juhakaup/keyboards/Cygnus v1.0/img/3x6.jpg

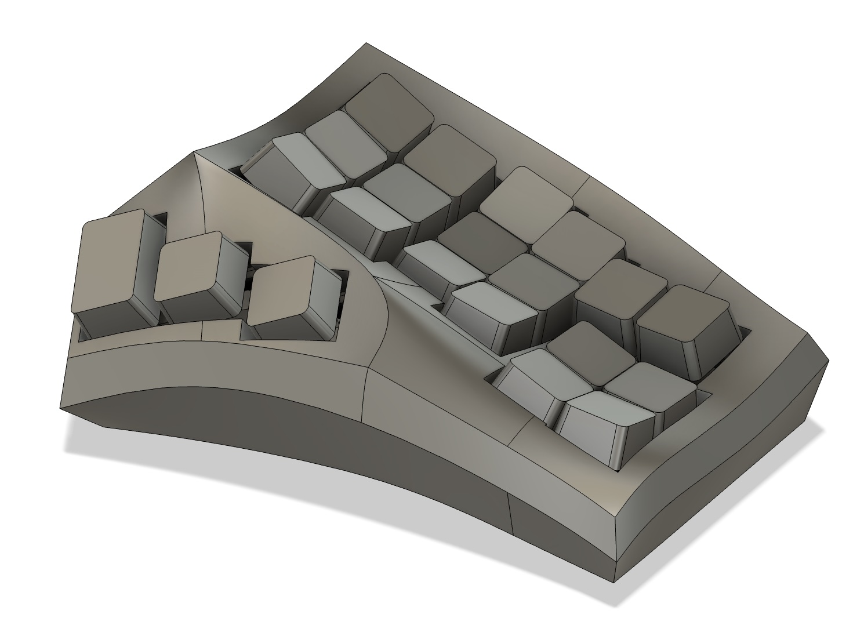
Cygnus v1.0/img/3x6.jpg
