juhakaup/keyboards/Cygnus v1.0/img/3x6_refined.jpg

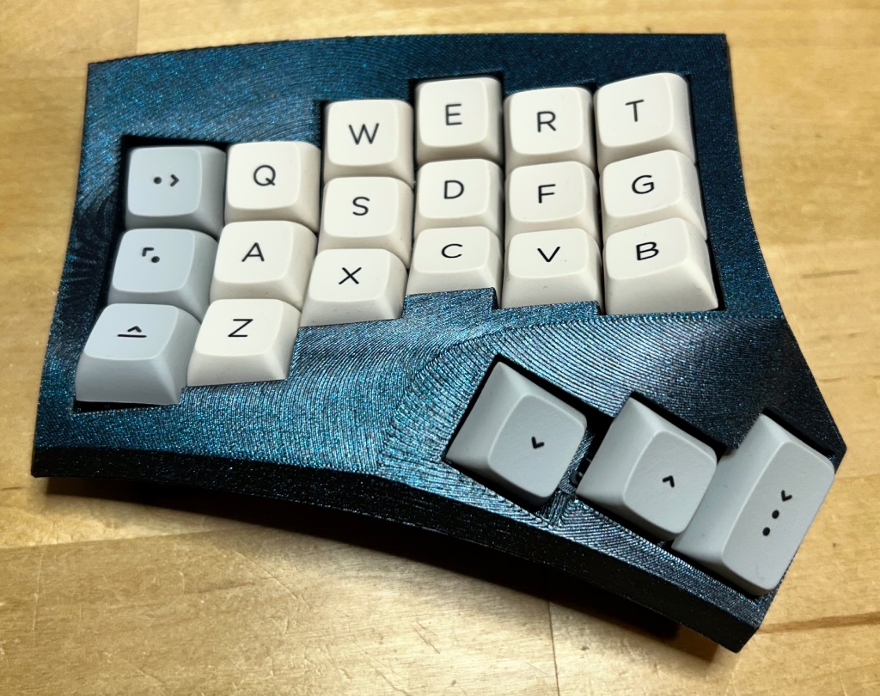
Cygnus v1.0/img/3x6_refined.jpg
