juhakaup/keyboards/Cygnus v1.0/img/4x6and3x5.jpg

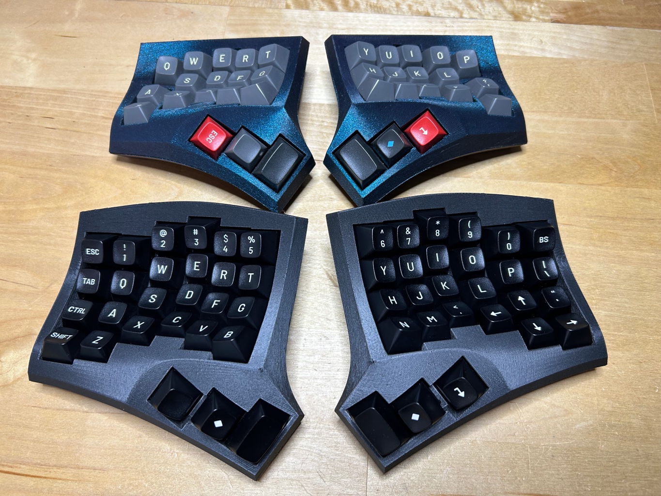
Cygnus v1.0/img/4x6and3x5.jpg
