juhakaup/keyboards/Cygnus v1.0/img/cygnus2.jpg

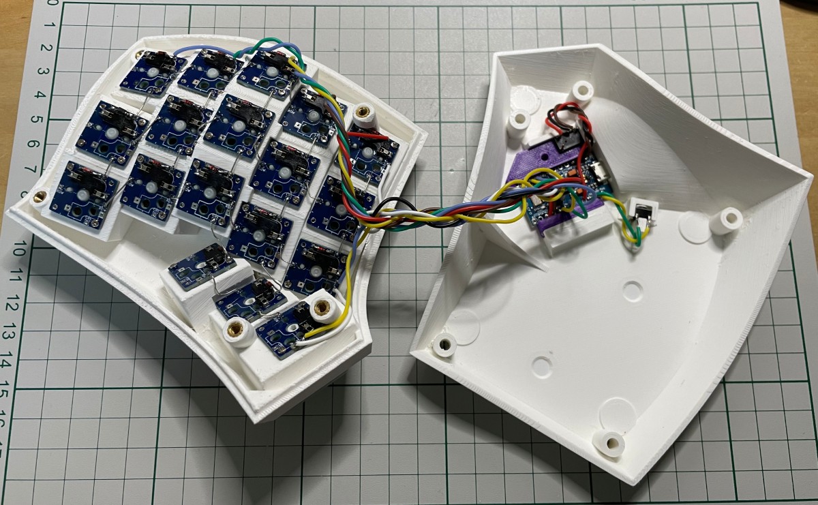
Cygnus v1.0/img/cygnus2.jpg
