juhakaup/keyboards/Cygnus v1.0/img/cygnus3.jpg

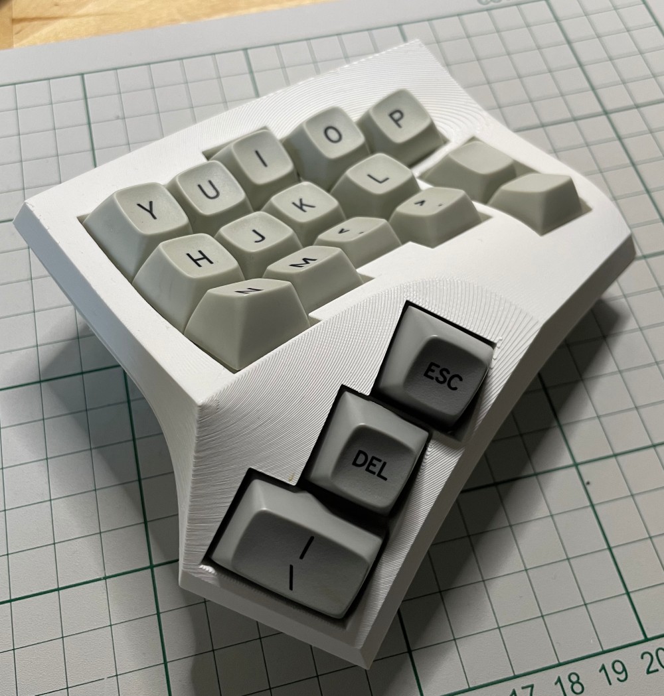
Cygnus v1.0/img/cygnus3.jpg
