juhakaup/keyboards/Cygnus v1.0/img/cygnus4.jpg

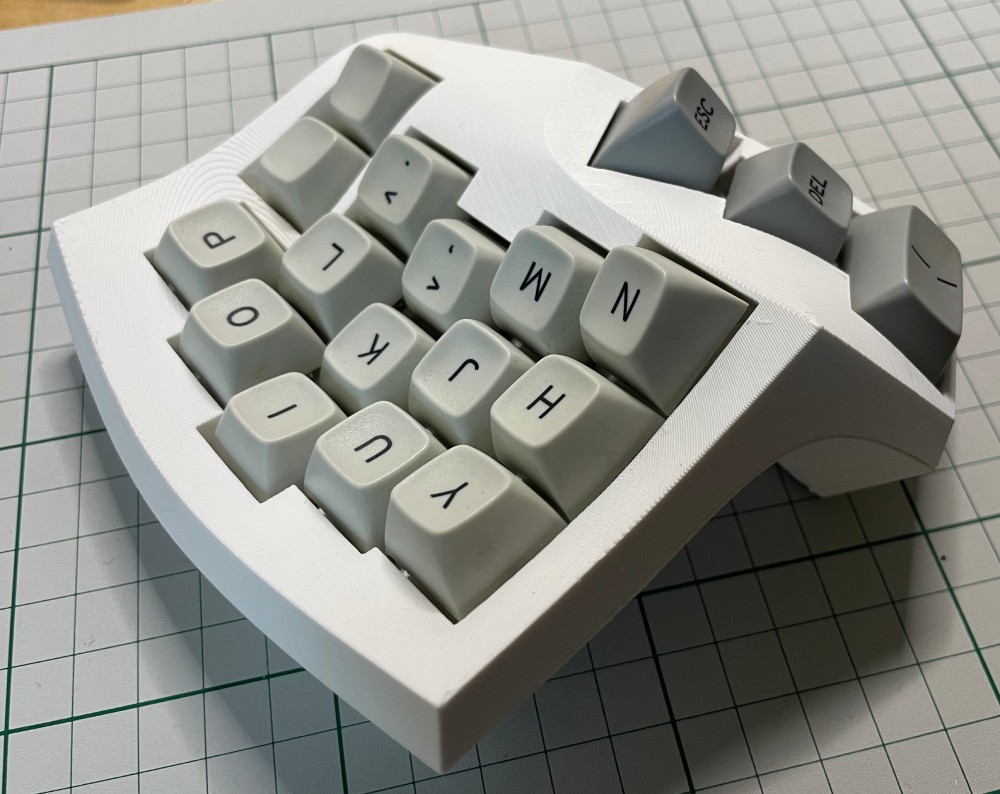
Cygnus v1.0/img/cygnus4.jpg
