juhakaup/keyboards/Cygnus v1.0/img/cygnus_wireless.jpg

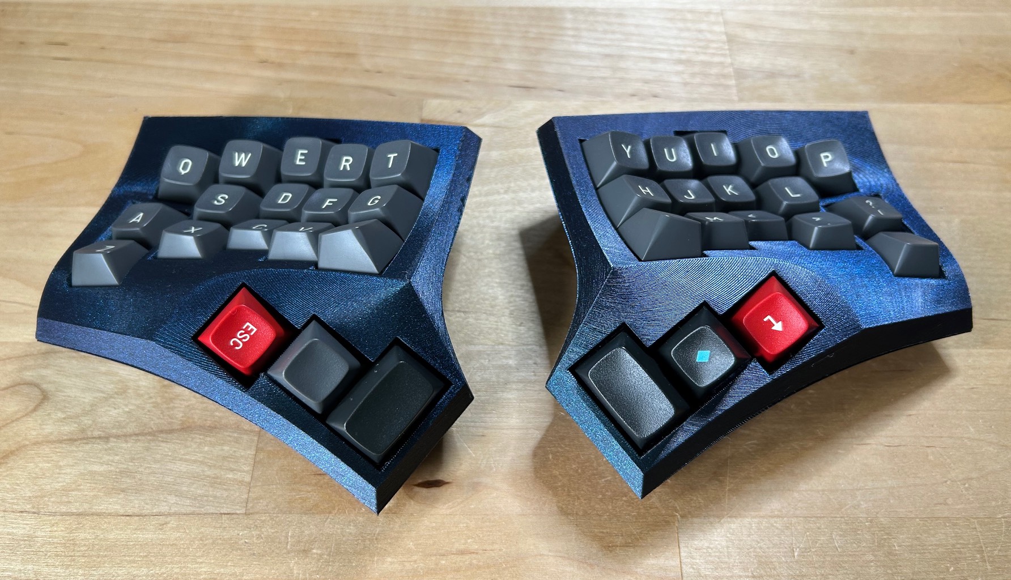
Cygnus v1.0/img/cygnus_wireless.jpg
