juhakaup/keyboards/Cygnus v1.0/img/fusion1.png

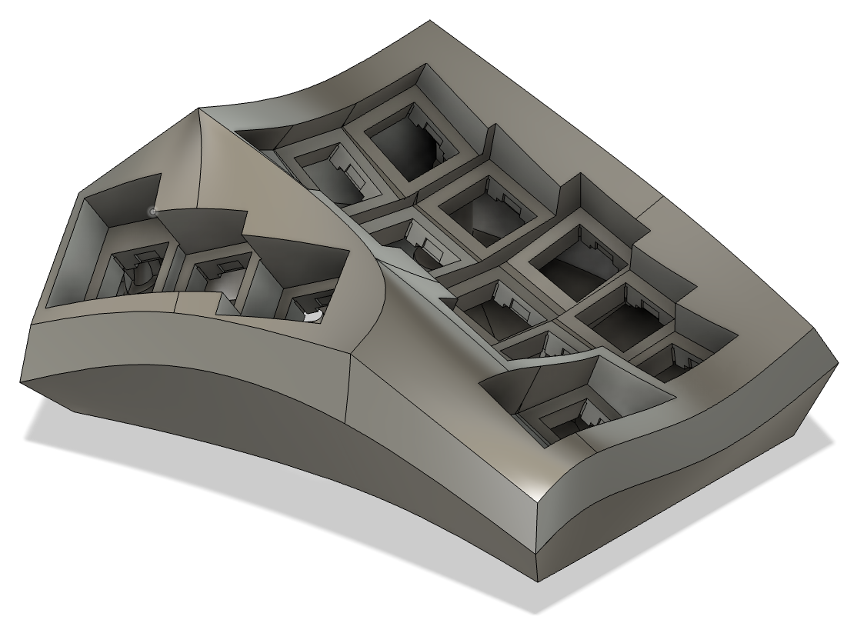
Cygnus v1.0/img/fusion1.png
