juhakaup/keyboards/Cygnus v1.0/img/fusion2.png

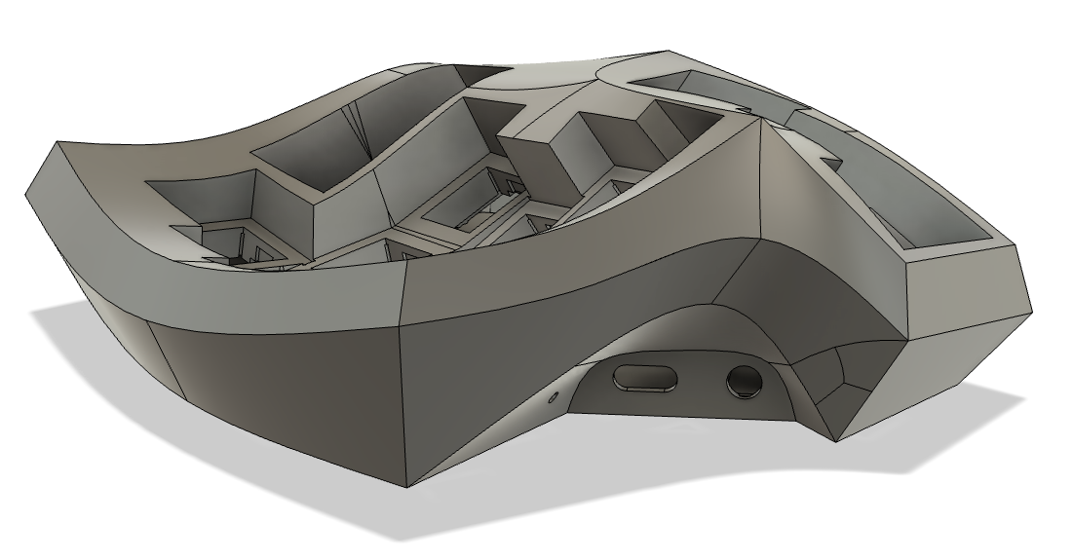
Cygnus v1.0/img/fusion2.png
