juhakaup/keyboards/Cygnus v1.0/img/fusion3.png

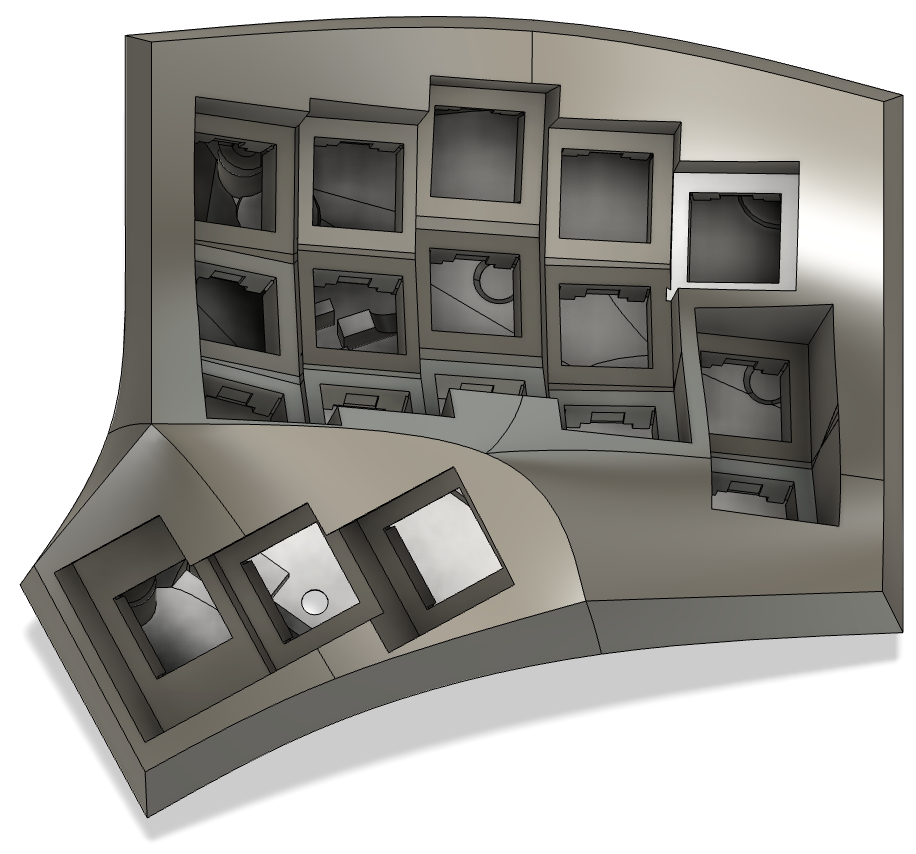
Cygnus v1.0/img/fusion3.png
