juhakaup/keyboards/Cygnus v1.0/img/fusion_unified_col5.png

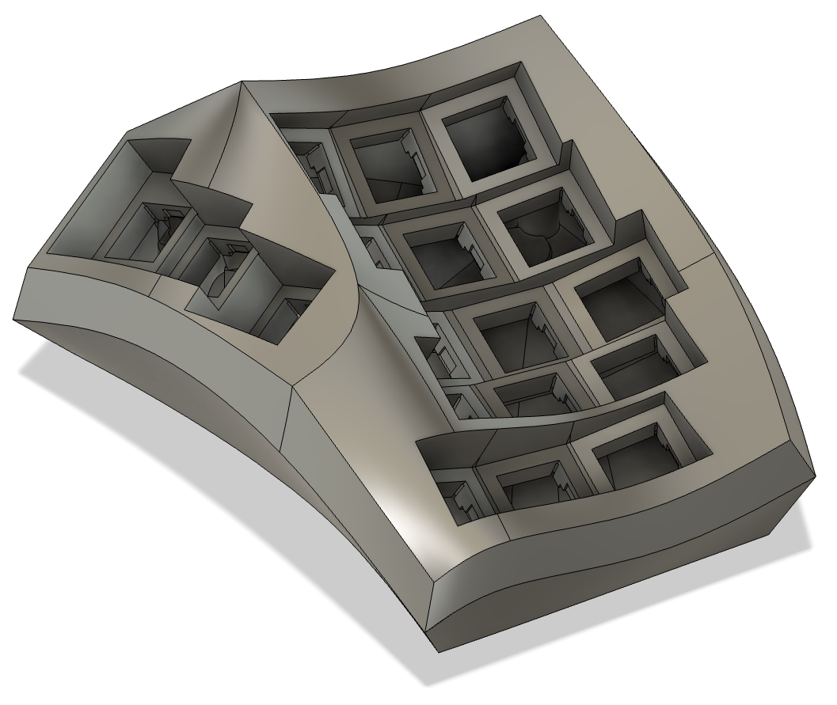
Cygnus v1.0/img/fusion_unified_col5.png
