juhakaup/keyboards/Cygnus v1.0/img/unicol_draft.jpg

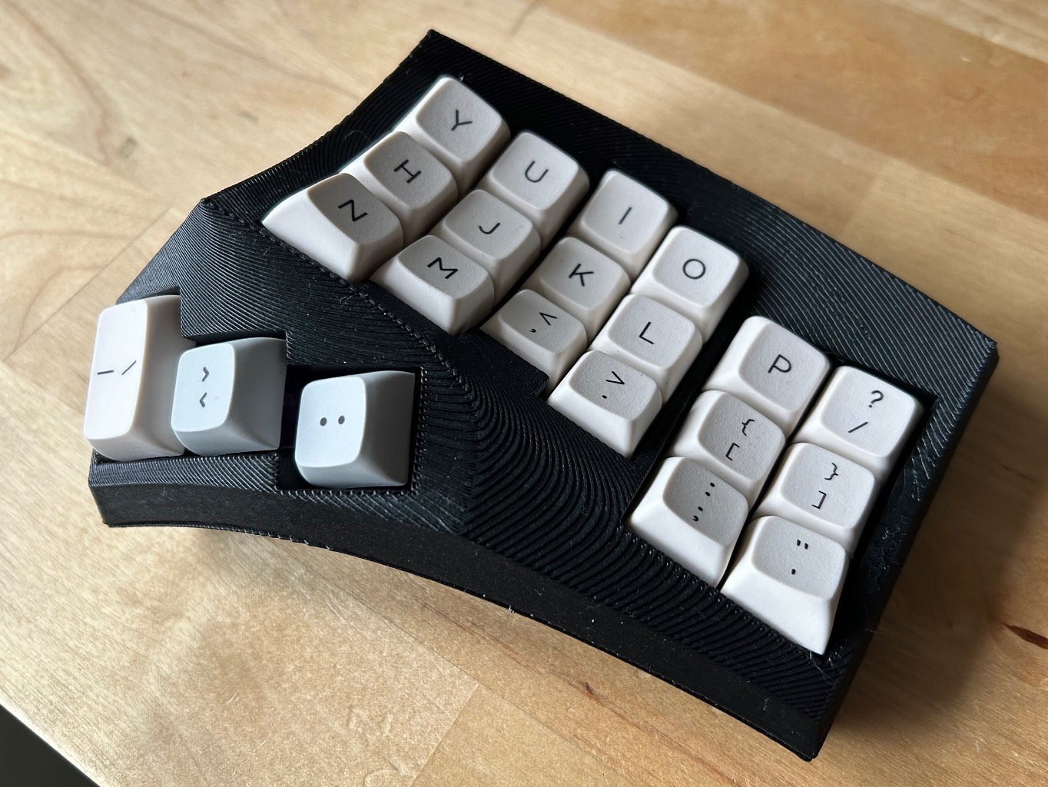
Cygnus v1.0/img/unicol_draft.jpg
