juhakaup/keyboards/Cygnus v1.0/requests and other experiments/controller_holder_rp2040/controller_holder_rp2040z_adapter.stl

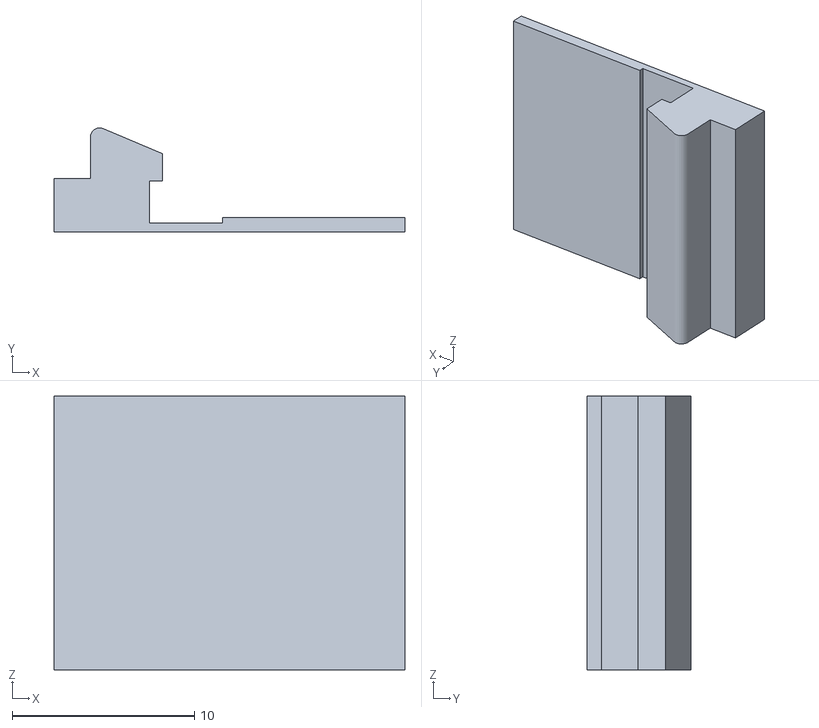
[picture p64: CAD file, 2024-09-02]
Cygnus v1.0/requests and other experiments/controller_holder_rp2040/controller_holder_rp2040z_adapter.stl
19.3 x 5.71 x 15.0
