juhakaup/keyboards/Cygnus v1.0/requests and other experiments/cygnus_top_unicol_2thumbkeys.step

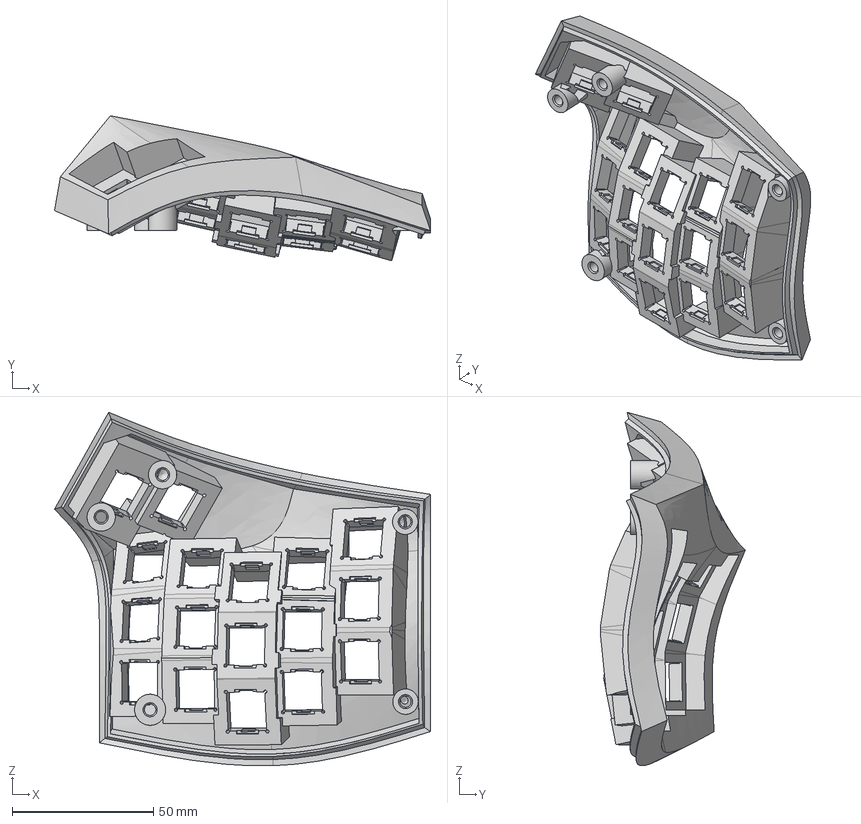
[picture p65: CAD file, 2024-04-13]
Cygnus v1.0/requests and other experiments/cygnus_top_unicol_2thumbkeys.step
132.9 x 51.1 x 125.0 mm
