juhakaup/keyboards/Cygnus v1.0/stl/controller_holders/controller holder xiao.step

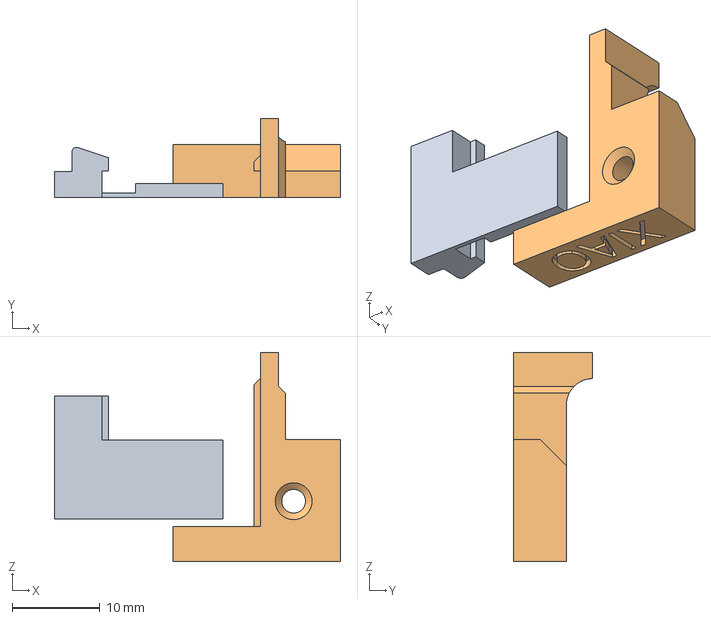
[picture p66: CAD file, 2024-10-27]
Cygnus v1.0/stl/controller_holders/controller holder xiao.step
32.7 x 9.00 x 23.9 mm
