juhakaup/keyboards/Cygnus v1.0/stl/cygnus 3x5/cygnus_3x5_top.step

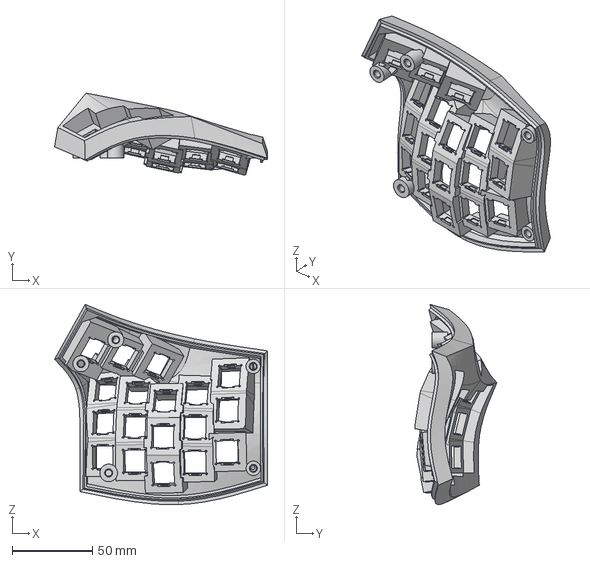
[picture p67: CAD file, 2024-04-06]
Cygnus v1.0/stl/cygnus 3x5/cygnus_3x5_top.step
132.9 x 51.1 x 125.0 mm
