juhakaup/keyboards/Cygnus v1.0/stl/cygnus 3x6/cygnus_3x6_bottom_wireless.step

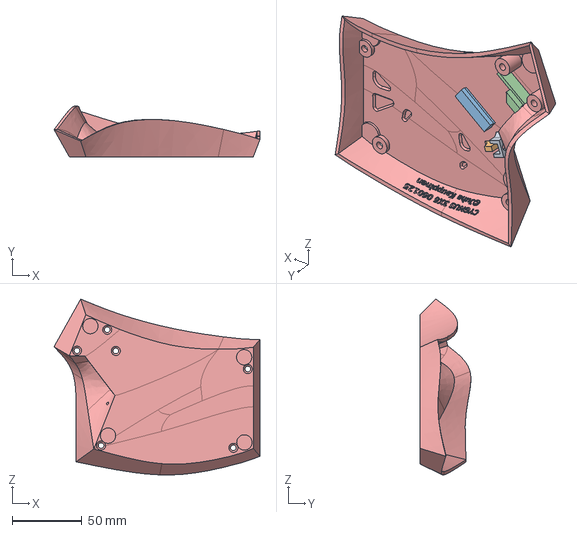
[picture p68: CAD file, 2025-01-10]
Cygnus v1.0/stl/cygnus 3x6/cygnus_3x6_bottom_wireless.step
147.9 x 36.4 x 126.3 mm
reset switch holder
controller holder wireless
