juhakaup/keyboards/Cygnus v1.0/stl/cygnus 4x6/cygnus_4x6_bottom_wireless.step

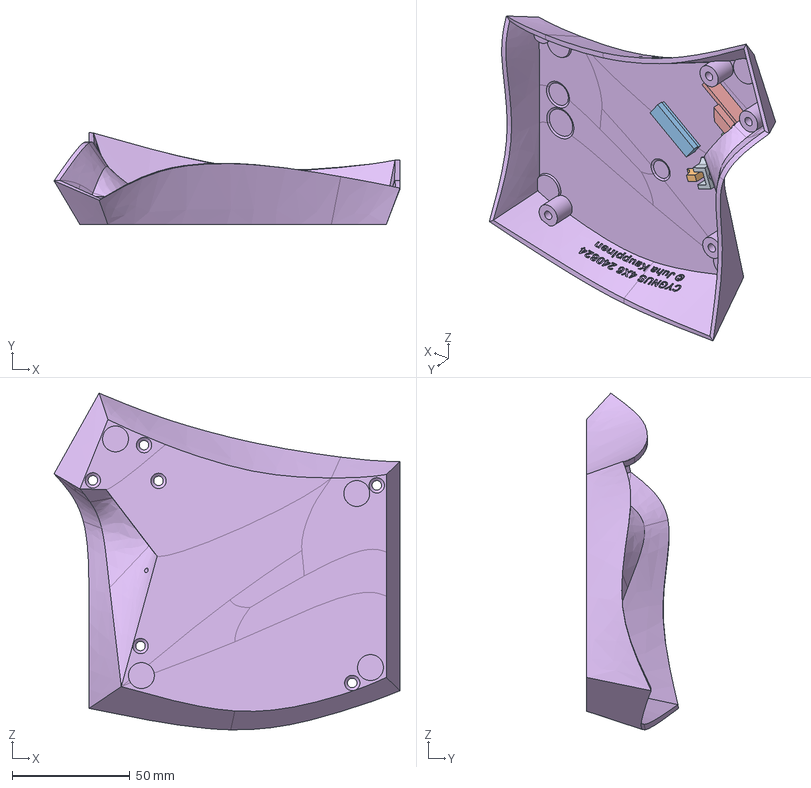
[picture p69: CAD file, 2024-09-14]
Cygnus v1.0/stl/cygnus 4x6/cygnus_4x6_bottom_wireless.step
146.9 x 39.1 x 143.0 mm
Thumb cluster
reset switch holder
controller holder wireless
