juhakaup/keyboards/Cygnus v1.0/requests and other experiments/controller_holder_rp2040/controller_holder_rp2040z_clamp.stl

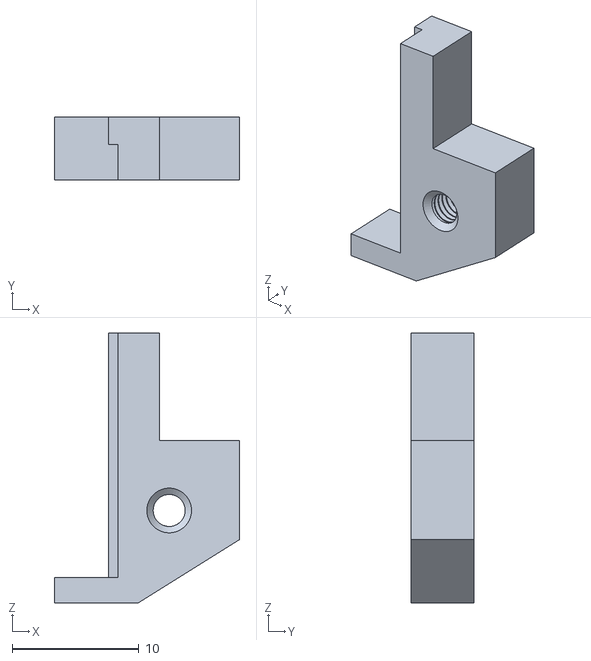
[picture p70: CAD file, 2024-09-02]
Cygnus v1.0/requests and other experiments/controller_holder_rp2040/controller_holder_rp2040z_clamp.stl
14.6 x 5.00 x 21.3
