juhakaup/keyboards/Cygnus v1.0/stl/controller_holders/controller_holder_supermini_wireless.stl

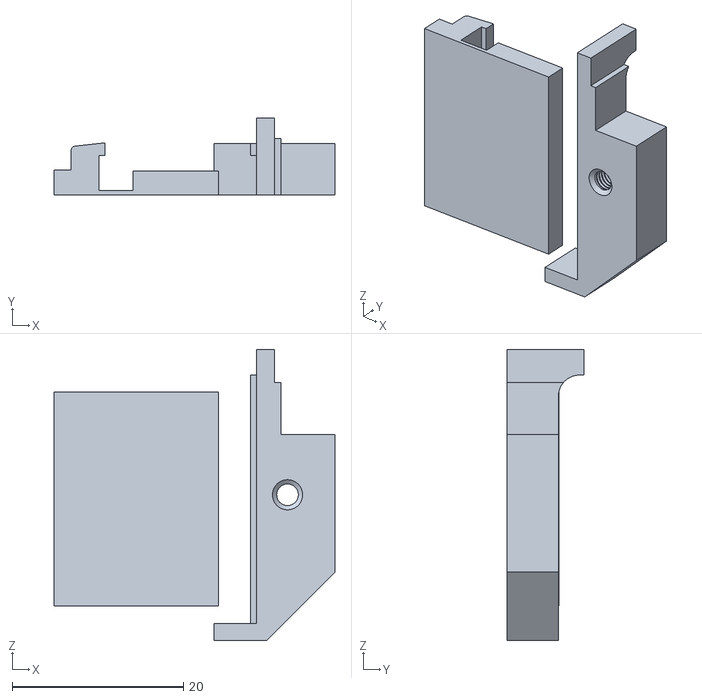
[picture p71: CAD file, 2024-03-31]
Cygnus v1.0/stl/controller_holders/controller_holder_supermini_wireless.stl
32.8 x 9.00 x 34.0
