juhakaup/keyboards/Cygnus v1.0/stl/cygnus 3x6/cygnus_3x6_top.step

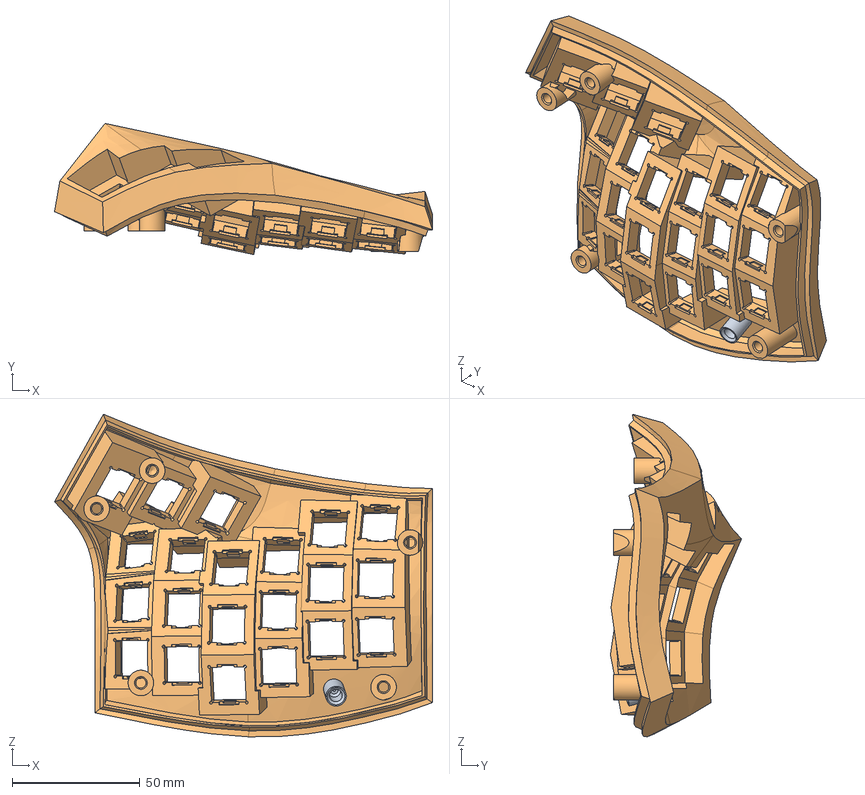
[picture p73: CAD file, 2025-01-10]
Cygnus v1.0/stl/cygnus 3x6/cygnus_3x6_top.step
147.9 x 51.3 x 126.3 mm
