juhakaup/keyboards/Cygnus v1.0/stl/cygnus 4x6/cygnus_4x6_top.step

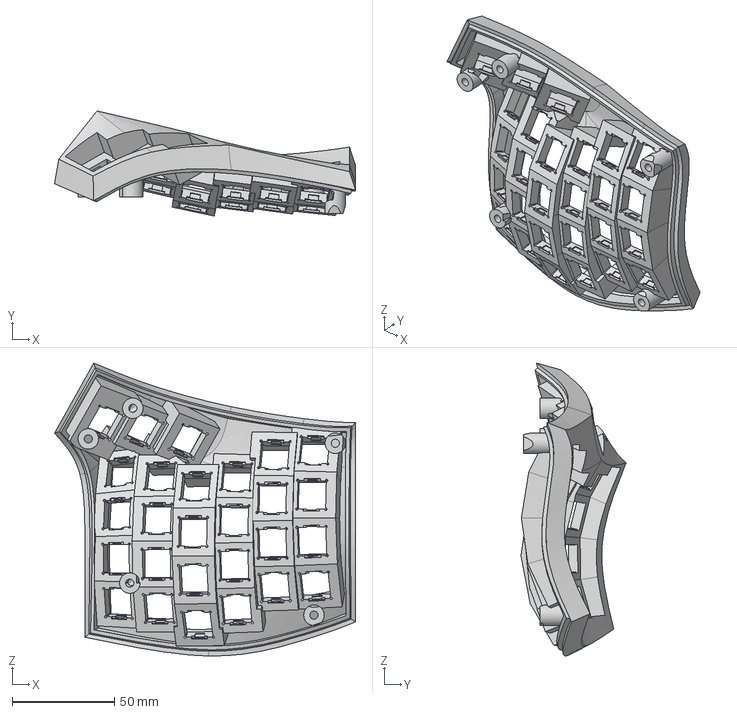
[picture p74: CAD file, 2024-09-14]
Cygnus v1.0/stl/cygnus 4x6/cygnus_4x6_top.step
146.9 x 51.3 x 143.0 mm
