juhakaup/keyboards/Cygnus v1.0/stl/controller_holders/controller_holder_rp2040zero.stl

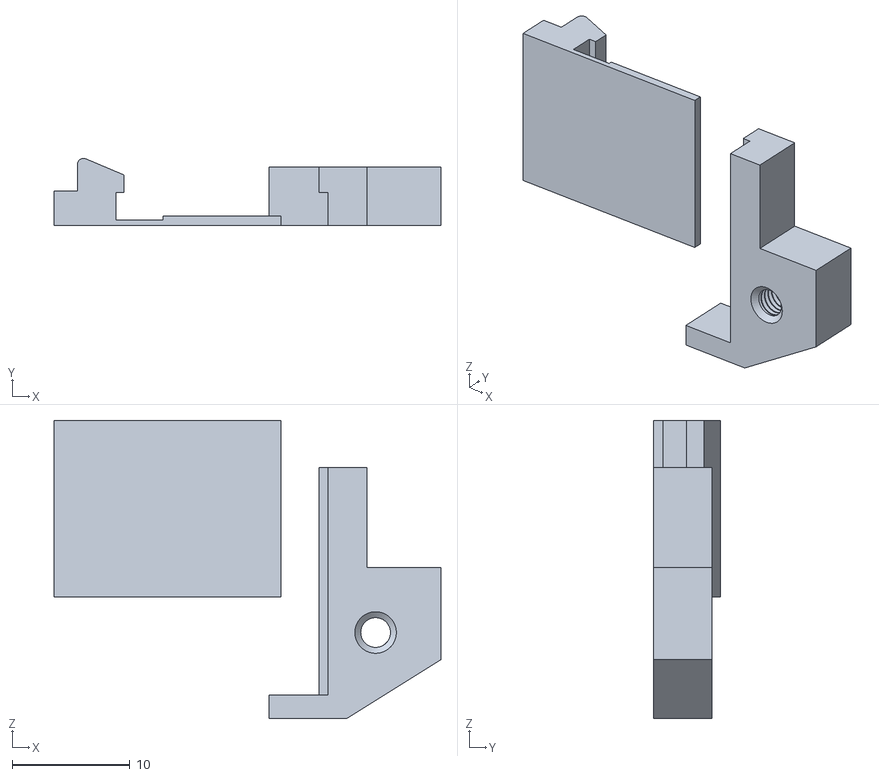
[picture p75: CAD file, 2023-10-15]
Cygnus v1.0/stl/controller_holders/controller_holder_rp2040zero.stl
32.8 x 5.71 x 25.3
