juhakaup/keyboards/Cygnus v1.0/stl/cygnus 3x5/cygnus_3x5_bottom.step

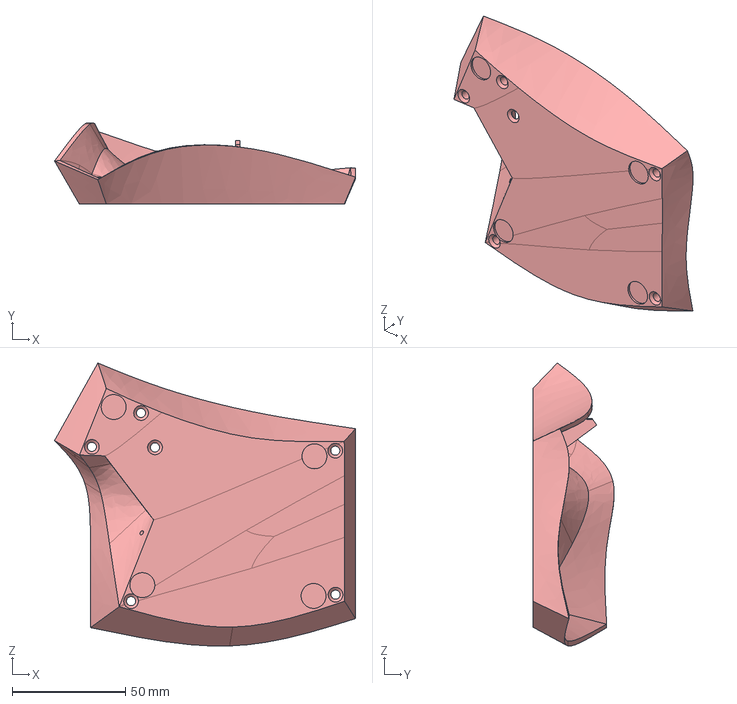
[picture p76: CAD file, 2024-04-06]
Cygnus v1.0/stl/cygnus 3x5/cygnus_3x5_bottom.step
132.9 x 35.9 x 125.0 mm
Switch
controller and jack
