juhakaup/keyboards/Cygnus v1.0/stl/controller_holders/controller_holder_elitec.stl

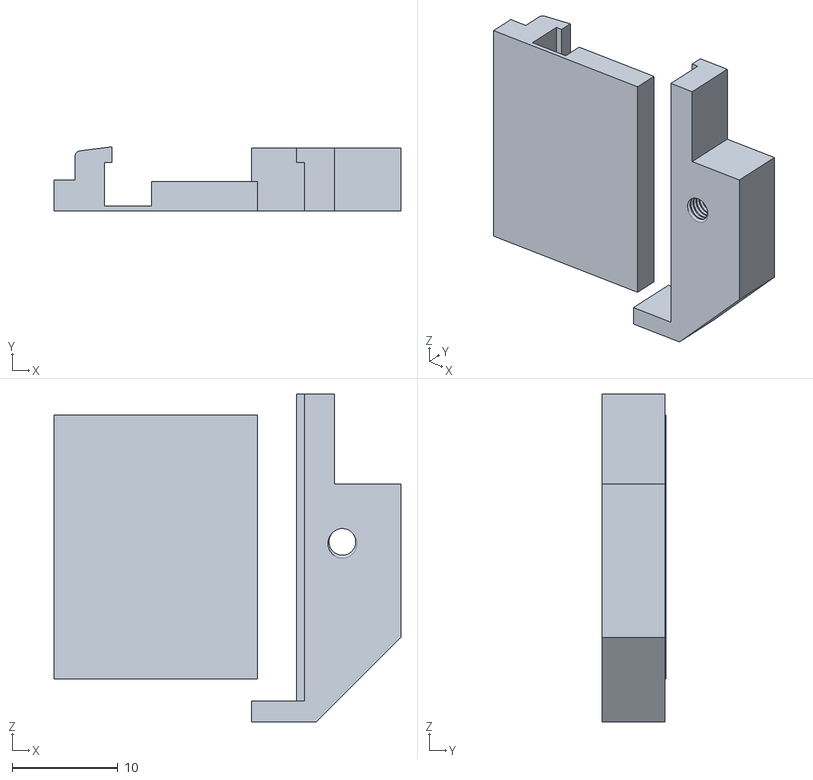
[picture p78: CAD file, 2023-10-15]
Cygnus v1.0/stl/controller_holders/controller_holder_elitec.stl
32.8 x 6.10 x 31.0
