juhakaup/keyboards/Cygnus v1.0/stl/controller_holders/controller_holder_promicro.stl

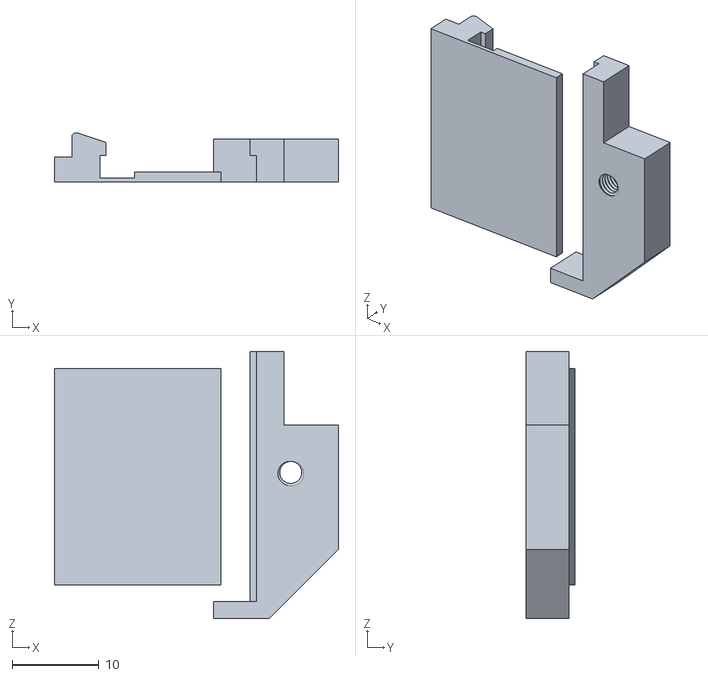
[picture p79: CAD file, 2023-10-15]
Cygnus v1.0/stl/controller_holders/controller_holder_promicro.stl
32.8 x 5.71 x 30.9
