juhakaup/keyboards/(list of files, cad)

Other CAD files:
Cygnus v1.0/requests and other experiments/cygnus_top_2thumbkeys.step
Cygnus v1.0/stl/cygnus 3x6/cygnus_3x6_bottom_wired.step
Cygnus v1.0/stl/cygnus 4x6/cygnus_4x6_bottom_wired.step
Cygnus v1.0/stl/cygnus 3x5/cygnus_3x5_top_unicol.step
Cygnus layout tester/sygnus_layout_tester.f3z
Cygnus v0.5/Case bottom.stl
Cygnus v0.5/Case top hotswap left.stl
Cygnus v0.5/Case top hotswap right.stl
Cygnus v0.5/Case top noswap.stl
Cygnus v0.5/Controller holder.stl
Cygnus v0.5/Jack holder.stl
Cygnus v1.0/requests and other experiments/cygnus_top_2thumbkeys.stl
Cygnus v1.0/requests and other experiments/cygnus_top_unicol_2thumbkeys.stl
Cygnus v1.0/requests and other experiments/old_3x6/cygnus_3x6_bottom.stl
Cygnus v1.0/requests and other experiments/old_3x6/cygnus_3x6_bottom_wireless.stl
Cygnus v1.0/requests and other experiments/old_3x6/cygnus_3x6_top.stl
Cygnus v1.0/requests and other experiments/old_3x6/cygnus_3x6_unicol_top.stl
Cygnus v1.0/stl/controller_holders/controller holder xiao.stl
Cygnus v1.0/stl/cygnus 3x5/cygnus_3x5_bottom.stl
Cygnus v1.0/stl/cygnus 3x5/cygnus_3x5_bottom_wireless.stl
Cygnus v1.0/stl/cygnus 3x5/cygnus_3x5_top.stl
Cygnus v1.0/stl/cygnus 3x5/cygnus_3x5_top_unicol.stl
Cygnus v1.0/stl/cygnus 3x6/cygnus_3x6_bottom_wired.stl
Cygnus v1.0/stl/cygnus 3x6/cygnus_3x6_bottom_wireless.stl
Cygnus v1.0/stl/cygnus 3x6/cygnus_3x6_top.stl
Cygnus v1.0/stl/cygnus 4x6/cygnus_4x6_bottom_wired.stl
Cygnus v1.0/stl/cygnus 4x6/cygnus_4x6_bottom_wireless.stl
Cygnus v1.0/stl/cygnus 4x6/cygnus_4x6_top.stl
