juhakaup/keyboards/(threads)

Thread 3 (2022-07-22):

Build guide please

tangbonze, 2022-07-22:
Hello there:
I am new to custom build Keeb. Your design really impressed me.
I can handle soldering but not sure the wire lines. Could you please kindly create a build guide or open the case and take a whole picture?
Thanks in advanced.

brneor, 2022-07-26:
+1 for some pics of the interior to help us see how you managed to fit the internals. It would be great!

evantravers, 2024-02-29:
I feel like the guide he has with the v1.0 is pretty doggone good: https://github.com/juhakaup/keyboards/tree/main/Cygnus%20v1.0

Maybe this is closed?

Closed 2024-03-03.

Thread 4 (2023-01-07):

Would it be possible to get the fusion files?

Nobodi99, 2023-01-07:
Hi,
I recently printed one half of your design to test and I really like the aesthetics but I would love to move the upper pinky key above the others and raise the innermost thumbkey because the middle key gets in the way for me.
Would it be possible to get access to the design files to modify it?

juhakaup, 2023-01-15:
Glad to hear you like the design.
Here is the link to the fusion files:
https://drive.google.com/file/d/1OVxvqivmw3vvyvD0ghFZgAA_TH4tXXlT/view?usp=sharing
Modifying the design may be quite challenging.

I'm working on a new version that is parametric and should be easier to modify.
I've uploaded a layout testing file to this repocitory, you may want to check it out as well.

edte, 2023-10-15:
Have you changed it? I also want to change the keys on my little finger, including the q key and p key.

juhakaup, 2023-10-15:
I've updated the repository, fusion files are now included. This version is completely rebuild and has parameters for key positions etc. I also included a version where the P and Q keys are with the other pinky keys.
I'll add documentation at some point, when I have time.

weilbith, 2024-03-04:
Thank you very much @juhakaup 🙏🏾
I loaded your project into Fusion 360 and looked into the history to learn which construction approach you chose. The key part for me was to create an object and cut out the key holes. My approach was connecting the key holes and then trying to build a case around it, connecting to the object faces. Etc. Was/is a pita and broke everytime the key whole layout changes due to prototypes. Will learn now how to construct objects properly.
This finally gives me motivation and hope again that I can "finish" my own keyboard vision.

Closed 2024-03-03.

Thread 6 (2024-03-01):

Choc switch version

johnlamb, 2024-03-01:
Any chance for a version supporting choc (V1) switches? The PCBs already has holder for the choc hot swap sockets and would be great to have the stl files for this.
Have tried adjusting the Fusion files myself but not up to speed with Fusion.

juhakaup, 2024-03-03:
I have actually tried putting choc switches to the case. Unfortunately the problem for adding support seems to be the height of the switches and shorter travel distance. For example the switches sit so deep in the thumb cluster, that you can't really press them. Also the short travel distance means that the switches need to sit quite proud.
So maybe the design could be altered to support the switches, but it's not really a priority for me at the moment.

I do enjoy using choc switches, but I'm planning to do different design for them.

johnlamb, 2024-03-03:
Cheers, makes sense. Same for me when I design choc keyboards, hard to adjust to mx switches due to thin walls etc.

johnlamb, 2024-03-03:
Cheers, makes sense. Same for me when I design choc keyboards, hard to adjust to mx switches due to thin walls etc.

Closed 2024-03-03.

Thread 9 (2024-03-29):

Controller Bracket for NiceNano

evantravers, 2024-03-29:
Hey there… curious if I would need to do any modification to the promicro brackets to accommodate a nicenano. Playing with the print I have, it seems a little low in the provided USB hole in the case.

juhakaup, 2024-03-29:
Unfortunately I don't have any nicenanos to test. The brackets for the elite-c are probably a better fit, as the usb port is insert in both of those designs.

justanothernguyen, 2024-04-12:
I used thhe elite-c bracket and it works great. SMD components need to be facing up.

evantravers, 2024-04-12:
Thank you for the helpful reply!

On Friday, April 12, 2024, justanothernguyen ***@***.***>
wrote:

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

Thread 10 (2024-04-01):

Step files?

sebastian-stumpf, 2024-04-01:
Hi there! Amazing project! I've printed a case and the layout feels fantastic!

I was wondering if you could add some step files to the repo. I'm trying to add a battery holder for the wireless 3x5 unicol version, but working with the stl files is a bit bothersome and I don't have a machine that can run Fusion.

And many thanks for opensourcing your work!

juhakaup, 2024-04-06:
I've added the files to the requests folder.

sebastian-stumpf, 2024-04-06:
Many thanks! This is much appreciated! :slightly_smiling_face:

Closed 2024-04-06.

Thread 11 (2024-04-11):

Choice of PCB

dudicoco, 2024-04-11:
First of all, thank you for this great project!

I was wondering what was the reason for the choice of the [PCB](https://github.com/e3w2q/su120-keyboard) instead of the more popular [amobea royale](https://github.com/mtl/keyboard-pcbs/tree/master/amoeba-royale) or [amobea king](https://github.com/JKing-B16/keyboard-pcbs/tree/master/amoeba-king).

I haven't used any of these myself so I have no idea if there are any pros or cons.

juhakaup, 2024-04-14:
Well I guess I liked the idea of fastening the pcb's with screws. Can't say that I would have done all that much research on the subject.
I've been thinking about adding rgb support, and probably the easiest way would be by adding support for amoebas or something similar. Haven't got any other boards at the moment, but I'll probably get some in the future.

Thread 12 (2024-04-12):

Any chance for a 4x6?

shensmobile, 2024-04-12:
I know it might ruin the design language of the board, but is there any chance you might consider making a version of this board with a numrow? I’m one of those ergo enjoyers that prefers a little bit less minimalism.

hailee0710, 2024-08-04:
Thumbs up for this, I really love to see the 4x6 version, can't live with the numrow

juhakaup, 2024-08-07:
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

Here's a sneak peek.

hailee0710, 2024-08-08:
wow, fabulous!
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

marioolofo, 2024-08-14:
Very nice @juhakaup
Can you share the model to print?

shensmobile, 2024-08-16:
Absolutely fantastic.  I can't wait to print it :D

juhakaup, 2024-08-25:
4x6 is released.

Closed 2024-08-25.

Thread 15 (2024-04-14):

Battery position?

laporchen, 2024-04-14:
I current making a wireless version of 3x5 v1.

You mentioned about using double side duct tape to keep battery in place.
I wonder if you can provide an example of the interior for wireless version.
I can't tell where should the position for battery be since I haven't got all the parts yet and the interior is very small.

Thank you in advance.

juhakaup, 2024-04-14:
Here is how I attached the battery.
It's about 30 x 20 x 7mm in size.
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

laporchen, 2024-04-14:
Thanks for the reference.
Btw, what kind of material did you use for this case, the color is magnificent.

juhakaup, 2024-04-14:
It's Burnt Titanium PLA by Flashforge.

fredrikjacobson, 2024-05-29:
What's the clearance like for the battery? I wonder if a larger one would fit or if this is already a tight fit. @laporchen what battery did you end up using?

juhakaup, 2024-05-30:
I have some 550mAh 503040 batteries that theoretically fit in the cavity, but would require fabricating some sort of stand to get them to stay in the odd position. The 250mAh 502030 batteries I have seem to last quite a while and fit in the case without too much trouble.

dudicoco, 2024-07-04:
@juhakaup what is the clearance in mm from the the bottom of the case to the switches pcbs?

juhakaup, 2024-07-05:
Well it's not quite that simple. The keywell is concave and I made the keyboard as low as possible, so some of the pcbs have pretty much no clearance at all. There really isn't all that much space inside the case, so you may need to a quite creative to fit a large battery.

Thread 16 (2024-04-15):

controller clamp mirrored thread is left-handed

georgewild42, 2024-04-15:
When mirroring the controller clamp in slicer, the thread becomes left-handed. Am I missing something here?

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

I would fix this myself by making the thread left-handed before mirroring, however I can't find the supermini wireless bracket in the Fusion file.

Thank you for this design, it's great. I am looking forward to building the wireless 3x6 as my first ergo.

juhakaup, 2024-04-21:
Yes this is an clear oversight on my behalf. In practice, the resolution of the 3d printed m3 thread is not that great, so it doesn't really affect the performance.

georgewild42, 2024-04-21:
Yeah, you are right it doesn't really matter. For anyone else with OCD however, I edited the STL file for the supermini wireless:

[controller_holder_supermini_wireless v1 LEFT HANDED.zip](https://github.com/juhakaup/keyboards/files/15051466/controller_holder_supermini_wireless.v1.LEFT.HANDED.zip)

Closed 2024-04-21.

Thread 17 (2024-04-26):

No reset button hole in Wireless 3x6 version

dhconr, 2024-04-26:
There is no hole for the reset button in the wireless version of the 3x6 bottom case
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

dhconr, 2024-04-27:
Created pull request  with fix.

Closed 2024-04-27.

Thread 19 (2024-04-27):

Case Doesn't Close Properly Due to Switch Socket Position 3x6

minchik, 2024-04-27:
When attempting to close the 3x6 version of the case, the switch socket's proximity to the bottom of the case prevents proper closure. This issue is caused by the socket's position being too close to the lower edge, resulting in an incomplete or forced closure.

Can you increase the height of the bottom part by 2mm?

[image](https://github.com/juhakaup/keyboards/assets/2690703/587bae05-a9e4-4f69-b846-4ad9afa0442f)

juhakaup, 2024-04-28:
Don't really want to do that, but I added a notch to the bottom so the socket should fit now. Let me know if it fixed the issue.

minchik, 2024-05-06:
Thanks! I have printed it again, and the issue is fixed.

Closed 2024-05-06.

Thread 20 (2024-05-01):

zmk firmware

Hlinyi, 2024-05-01:
Thank you very much for the author's open-source design. Based on the model provided by the author, I have made some modifications.
Added the position of the main control bracket and the position of the distribution board. Chamfer the outer shell.
However, only applicable to zmk firmware.

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
[Uploading 天鹅座1.0V2.zip…]()

Hlinyi, 2024-05-01:
[Uploading 天鹅座1.0V2.zip…]()

Hlinyi, 2024-05-01:
I've sent the file here, you can download it if you need it.

https://github.com/Hlinyi/Cygnus-v1.0-Modified-version

Thread 25 (2024-06-01):

1mm thick walls on bottom risk of breaking when printing?

LarssonMartin1998, 2024-06-01:
Hey,

First I want to apologize if this is not an issue. I have no experience at all when it comes to 3D printing. I am trying to print this keyboard with the help of jlc3dp's services. I uploaded the 3x5 uniform top and the regular bottom, plus the mirrored versions.

They replied with a warning, I'll quote them from here:

"The wall thickness of those indicated red area is too thin, which has high risks of loss, deformation, crack, or damage during the printing process.

Could you please confirm if the risks are acceptable for you?

If not, could you please kindly increase it to be at least 1.0mm to proceed? 2.0 mm will be better."

Here is the image in question:
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

I tried to print MJF PA12-HP Nylon, and here is what they said about the different materials:

"Kindly noted resin has the lowest requirements for the wall thickness, which is at least 0.8m and 1.5mm is better. But the risks still exist for the red areas mentioned in the picture.

Kindly noted, nylon is more flexible for resin is brittle. Please refer to the design guideline in this [link](https://jlc3dp.com/help/article/212-3D-Printing-Design-Guideline)"

I wanted to bring this to your attention, but I also wanted to ask if this is okay to print, maybe they're just being overly cautious? Not sure.

evantravers, 2024-06-01:
Hey! I'm pursuing the same path here: https://github.com/juhakaup/keyboards/discussions/23

turns out you can say "pretty please" and accept the risk and they'll print it anyway. I've got one from PCBway coming soon, I'll report back in that thread. If you want, join the discussion on the other thread.

LarssonMartin1998, 2024-06-01:
> Hey! I'm pursuing the same path here: #23
>
> turns out you can say "pretty please" and accept the risk and they'll print it anyway. I've got one from PCBway coming soon, I'll report back in that thread. If you want, join the discussion on the other thread.

Hey,

Thanks for the suggestion, I got the same sentiment from jlc3dp, they told me that they could still print it so long as they had my written consent that I am willing to accept the risk. However, as the Nylon printing for all of the parts is roughly $80, I wanted to make sure that it's feasible before committing to it.

I'll definitely join your thread! Just a question, what is the rough ETA for your printed case? Wondering if I should wait and see your result, wait for the owner to reply to this issue, go ahead and just learn some basics of modeling so I can increase the width myself, or just go for it.

evantravers, 2024-06-01:
> what is the rough ETA for your printed case

PCBway's production status says 8 days, then shipping to CONUS from China, so.. ~14ish?

I will say, unless you are doing something like Nylon or Resin printing, I think the shipping cost is pretty prohibitive doing PCBway for this. Next time I'm certainly going to use local 3d printer. I think shipping alone was the cost of printing two cases. (~80 USD)

guategeek, 2024-06-01:
I have not printed the Cygnus yet, but I have two 3D printers and have five years of experience 3D printing.

Looking at the image those thin portions are in the bottom plate so even if they were open it wouldn't really matter (its not a structural part of the case). Having even a single layer of plastic (if the print at 0.2mm layer height) there would help keep dust out of the case.

I'm guessing those areas are cut out for clearance issues so modifying the model could make the switches (well the single key pcbs on the switches hit the bottom and cause the case to not close correctly.

I would say you are probably fine getting it printed, and as far as materials I would say go with MJF PA12-HP Nylon (especially if its made with the SLS process) if you can, its going to make for a much stronger case. Resin prints are much more brittle than FDM and SLS prints so if you go that rout be aware that a drop could easily break the case.

LarssonMartin1998, 2024-06-01:
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

Thank you for the information, I value it very much, means a lot! I'll go ahead and order it in MJF PA12-HP Nylon. I'll give an update here whenever I recieve it, but I'll go ahead and close it.

Closed 2024-06-01.

Thread 28 (2024-06-22):

Tenting?

franco-g-s, 2024-06-22:
The design looks great, but I was wondering what the tenting angle currently was. It looks about 10º but I was wondering if there are plans for a version with a more aggressive tent or an attachment.

juhakaup, 2024-07-04:
I don't recall if I had any specific angle in mind when I constructed the model, but you're probably right about the angle.
I haven't thought about having more aggressive angle myself, but I've seen some attachments made in the fingerpunch discord.

Thread 29 (2024-07-04):

Add hole for LED battery indicator

dudicoco, 2024-07-04:
Hi,

Thank you for this great project.

Would it be possible to add a hole for an LED so we can get battery status indication?

Thanks

juhakaup, 2024-07-04:
Yes its possible, I've thought about it myself.
I haven't looked into this too much, so if you have any ideas on how to implement it I would appreciate it. (what kind of hardware to use, does the firmware need to be updated)

If you just need a hole for a led, that can be done in a slicing software quite easily.

dudicoco, 2024-07-04:
@juhakaup i'm still unsure about the exact details of the implementation but I did find this repo: https://github.com/caksoylar/zmk-rgbled-widget

Also found this PR: https://github.com/zmkfirmware/zmk/pull/1120

Would it be possible to add a hole for the LED until we figure out the implementation details? Asking for this since I need to place an order for the 3d printed case.

Thanks

juhakaup, 2024-07-06:
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
This is what I came up with. It uses a 3mm led, that should be easily accessible.
There isn't a lot of room in the case, so I placed the led at an angle to make the installation easier.
I didn't want a large hole in the case, so I made a 1.8mm hole so that you can use something like transparent filament as makeshift lightpipe.

Let me know if you want to try this out, so that I can make the change to the appropriate model and upload it to the requests folder.

dudicoco, 2024-07-16:
Thanks @juhakaup!

I guess I need to be 100% sure that this will print out ok since i'm printing the case over at JLCPCB.

Do you think there could be issues with the print or with the fit and installation of the LED?

Thread 30 (2024-07-29):

Battery switch position

laporchen, 2024-07-29:
I'm working on a wireless version of cygnus.
I finally got myself some battery switch to finish my build, but I notice the switch is too big for the position that supposes to fit.
Can I ask for an image of how should it look like if it fits correctly? My switch suppose to be the same size as the document suggests.

laporchen, 2024-08-09:
Thanks for your reference. I will take a look at mine when I have time.
But my switch toggle would stuck in the cutout for it. I think I'll grind down some part for the switch to move

Thread 33 (2024-09-02):

multiple parts in controller stl

maxyurk, 2024-09-02:
I tried to order a 3d print for jlc and got the following message for the controller parts:

> "Multiple parts are detected in your file, sorry to tell you that each file could only support 1 part for printing, please kindly split the multiple parts into single files to upload separately. Thanks !"

I don't have much experience with 3d modeling.
I'm trying to print the rp2040 4x6 variant.
I installed fusion360 and opened the `cygnus_3x6.f3z` file, tried to figure out which part I need to mark visible and which not and got lost.

Could you please point me to the items I need checked for it?
Or upload the STLs splitted if that's not too much trouble.

TIA

Closed 2024-09-02.

Thread 36 (2024-09-18):

QMK Config for 3x5

zvakanaka, 2024-09-18:
I'm new to QMK/keyboards. I'm building a 3x5 and was able to get the left side working after some changes to crkbd (have not wired the right side yet).

Compiling with QMK cli required disabling RGB and OLED features in `rules.mk` (I think the firmware was waiting for OLED i2c before allowing the keys to work):
```
RGB_MATRIX_ENABLE = no
RGBLIGHT_ENABLE = no
OLED_ENABLE = no
```

At first it was mirrored/backwards/reversed (typing "qwert" on this left side produced "trewq" and the same goes for the other rows too: "asdfg" was "gfdsa" and "zxcvb" was "bvcxz"). Changing `info.json` `matrix_pins.cols` to have the last 5 columns reversed fixed it.

<details>
<summary>Compile Details</summary>

Here's the compile:
```
qmk config compile.keyboard=crkbd/rev1 compile.keymap=default

qmk compile -e FORCE_LAYOUT=LAYOUT_split_3x5_3
```

This is only needed for Linux to flash to a Pro Micro:
```
avrdude -p m32U4 -P /dev/ttyACM0 -c avr109 -U flash:w:crkbd_rev1_default_LAYOUT_split_
3x5_3.hex
```
</details>

Is there a QMK firmware that would immediately work with this keyboard for the 3x5 version? I am considering using dactyl minidox QMK for a future build, since that looks very similar.

zvakanaka, 2024-09-27:
I finished the build. One thing that got me was I assumed the right side's columns were mirrored, but they are in the same order as the left side. A wiring diagram for the right half would be awesome for those building this.

Here's a vial-qmk fork: https://github.com/vial-kb/vial-qmk/compare/vial...zvakanaka:vial-qmk:vial?expand=1

Closed 2024-09-27.

Thread 37 (2024-09-25):

Is a version with no switches on the thumbcluster possible?

Ben0981, 2024-09-25:
Hi, is it possible to get a version of the 3x6 fusion360 files without anything on the thumbcluster? I want to put thumbsticks there instead of the three switches, but as soon as I try to delete or modify anything in the model I get tons of errors.

juhakaup, 2024-10-12:
Sorry for delayed response.
You can remove switches by removing them from the step that cuts the holes. Click on one of the faces of the thumb cluster, and it should highligt the step on the timeline.
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

Double click the step to modify it and choose the tool bodies -button.
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

You should be able to remove the bodies by browsing to each individual switch holder component on the thumb cluster and ctrl-clicking on the negative -body.
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

Then you should be left with keyless thumb cluster to work with. There might be some errors on the timeline where I've done some cleanup, but they should not be anything severe.
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

Thread 44 (2024-10-26):

Which controller bracket for the NRF52840

eugenenelou, 2024-10-26:
Hello, I'm using the NRF52840 wireless controller listed in the parts. Which controller bracket can I use ? the board is 18x33mm and the existing brackets all seem to be shorter than this.

juhakaup, 2024-10-27:
The one in the wireless folder.

eugenenelou, 2024-10-27:
Oh thanks, I had missed it.

juhakaup, 2024-10-27:
I decided to move the files around a bit. All the brackets are now in the same diectory.

Closed 2024-10-27.

Thread 47 (2024-12-10):

Wireless version Fusion File

Dafeigy, 2024-12-10:
Hi, I really like your design and I successfully print them with bambu A1. I am working on 3x5 wireless version and I noticed that there are two irregular grooves at the bottom plates (`/Cygnus v1.0/stl/cygnus 3x5/cygnus_3x5_bottom_wireless.stl`), and it seems very fragile so I was planing to remove them. I am new in fusion360 so I don't know how to edit `.stl` files, so can you provides a wireless version fusion files? Thanks again for your excellent work!

juhakaup, 2024-12-10:
Hi. The holes are there to make room for the hotswap sockets. If you remove them you may have issues with the sockets pushing against the bottom.

If you still want to remove them, or to make them a bit less thin, probably the easiest way is to do it in the slicer. You should be able to add a geometric shape, like a box, through the slicer menus and combine that with the model to solve the issue.

I've printed several cases and haven't had any issues with the wall thickness.

Dafeigy, 2024-12-11:
Many thanks! In that case I will keep those holes :)

Thread 50 (2025-01-17):

In which orientation should I print the top?

repercussion, 2025-01-17:
Wondering how you have printed the top. I've tried twice using tree supports, but the print has failed both times at the thumb cluster. Perhaps I'm just going too fast.

Both attempts have been horizontal with the inside of the shell face down.

The STLs come balanced on the top and I can't make out from the lines in your print's image how you did it.

juhakaup, 2025-01-17:
I usually print them flat, as in just rotate the STL 90°. I haven't had issues with this orientation, but I've heard that others have.
I've also printed them vertically so that the top halve stands on the square at the side of the thumb cluster, this is useful if you want to sand the case to make it smoother.
Speed isn't a huge issue for me when printing these cases. My old prusa printer isn't fast, but it's reliable, so it's kind of set it and come back the next day for me.

repercussion, 2025-01-17:
Very much appreciate the input. The confirmation helps.

This seemed a bit much:
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

I will attempt printing in this orientation again:

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

Thank you!

I will try again with normal supports and slow the print right down.

Closed 2025-01-17.

Thread 51 (2025-02-15):

How/where to wire switch for wireless version?

gbartlett82, 2025-02-15:
This is not noted in the build docs.

Is the switch wired in-line between the battery and the B+ terminal?

That is what I came up with.  Of course doing this means the keyboard would need to be turned on in order to charge the battery.

juhakaup, 2025-02-15:
Yes, that's how you do it.
The charge controller is build in the controller itself, so you need to have it on in order to charge the battery.

Thread 53 (2025-02-22):

Alps version

christoph-cullmann, 2025-02-22:
Hi,

I love the design, especially the cygnus_top_2thumbkeys.step that can just be wired up like a Ferris :)

What would be really cool would be support for other switches, like Alps (or even Space Invaders), the needed cutout sizes are well documented e.g. here https://kbplate.ai03.com/

juhakaup, 2025-03-21:
Shouldn't be a huge issue to adapt the design, just needs a bit of testing. I might have some alps switches to try out, I should have some matias switches, if they are compatible.

christoph-cullmann, 2025-03-23:
:) Cool. Matias switches are compatible, yes.

Thread 54 (2025-03-17):

Is the 4x6 wireless only?

Krumpet, 2025-03-17:
From the notes on the 4x6 that's what I gather, that there's ZMK firmware for it so when building a 4x6 it should be using the wireless variant with the appropriate MCU and such. Just making sure that's the case. Probably gonna be my next build, so thanks for this project!

juhakaup, 2025-03-18:
There is a wired version of the case, so you can totally build a wired keyboard if you want.
What I haven't provided is the firmware, so you'd need to figure that out yourself, maybe you could use the one for silakka54 as it has the same layout.

Thread 56 (2025-04-30):

3x5 space for 400mah lipo?

falconmick, 2025-04-30:
Howdy

The recommended lipo is a 240 mah lipo which is slightly smaller than the only 3.7v lipo I can easily access which is a 400mah that comes in at 38x25x6mm, is there likely enough space in the 3x5 for this?

juhakaup, 2025-05-01:
I'd say probably not. There is surprisinbly little space inside the case.

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
Maybe it could fit above the controller if attached to the top of the case, but it's still very tight.

falconmick, 2025-05-01:
Thanks

Thread 57 (2025-04-30):

Most corne/crkbd firmware requires two wires for serial communication.

zfralish, 2025-04-30:
Love the keyboard, have built a wireless already and is working great.

Trying to build a wired version as well and I am running into an issue I don't understand.

I followed the wiring diagram from the readme, but all qmk corne firmware seems to require 4 wires.

In my case I have a pro micro (have also tested with elite c) with TX0 - TX0, RX0 to RX0, GND - GND, VCC - VCC. This is the only way to corne firmware works.

I am not sure if this is something misconfigured on my side or if something has changed with respect to the corne firmware since the docs were written. I am just using the default firmware from qmk. I have also tried the legacy, common, and r2g variants.

This is not really an "Issue" as it works fine this way, this is just not how i understand serial communication to work, and would like to understand why this is the case.

juhakaup, 2025-05-01:
Probably a change with the v4 corne.
The documentation for the classic corne still talks about 3 wire trs cable.
https://github.com/foostan/crkbd/blob/main/docs/corne-classic/buildguide_en.md
QMK does support serial communication with 3 or 4 wires, so it's just a matter of configuration. Part of the reason I went with corne firmware was to avoid doing configuration, so I'm probably not the right person to talk about that.
Qmk configurator has crkdb/rev1 that could be for the older version, if you want to check that out.

axhixh, 2025-05-06:
Use of 3 or 4 wires to communicate between the two halves depends on the protocol used. If you use I2C then you will need 4 wires. If you want to use "serial", not that I2C isn't serial, you can use either 3 or 4 wires based on half-duplex or full-duplex mode. It you use bitbang, again you only need 3 wires.

See https://docs.qmk.fm/drivers/serial

Thread 60 (2025-06-14):

On the 4x6 Build Notes, is that an RGB LED shown with hookups to the Nice!Nano?

gbartlett82, 2025-06-14:
If so, I was unable to find any reference to it on any of the other pages.

Continuing on, if so:
-  what resistor values should be used
- assuming the resistor is between the controller and the LED, yes?
- is there a part number (or product link) for the RGB LED?

Thank you.
-g

gbartlett82, 2025-06-15:
That does look like an interesting feature to have.  If I could retrofit it into my 4x6, even better :)

-g
