juhakaup/keyboards/(commit log)

2022-06-12 Add case files
    [Case bottom.stl, Case top hotswap left.stl, Case top hotswap right.stl, Case top noswap.stl, Controller holder.stl, Jack holder.stl]
2022-07-04 replaced the jack holder with a correct file
    [Jack holder.stl]
2023-01-15 Add layout tester
    [sygnus_layout_tester.f3z]
2023-10-15 Version1 files
    [controller_holder_elitec.stl, controller_holder_promicro.stl, controller_holder_promicro_long.stl, controller_holder_rp2040zero.stl, cygnus_case_bottom_right.stl, cygnus_case_top_right.stl, cygnus_case_top_right_unicol5.stl]
2024-02-29 Thicker posts, fix some clearance issues
    [cygnus_case_bottom_right.stl, cygnus_case_top_right.stl, cygnus_case_top_right_unicol5.stl]
2024-03-02 Cleaned some edges and removed artefacts
    [cygnus_case_top_right.stl, cygnus_case_top_right_unicol5.stl]
2024-03-31 Add 3x6 and wireless stls, update docs
    [controller_holder_elitec.stl, controller_holder_promicro.stl, controller_holder_promicro_long.stl, controller_holder_rp2040zero.stl, controller_holder_supermini_wireless.stl, cygnus_3x5_bottom.stl, cygnus_3x5_bottom_wireless.stl, cygnus_3x5_top.stl]
2024-04-06 Add 3x5 step files
    [cygnus_3x5_bottom.step, cygnus_3x5_bottom_wireless.step, cygnus_3x5_top.step, cygnus_3x5_top_unicol.step]
2024-04-13 experimental two thumbkey version
    [cygnus_top_2thumbkeys.step, cygnus_top_2thumbkeys.stl]
2024-04-13 add two thumb unicol
    [cygnus_top_unicol_2thumbkeys.step, cygnus_top_unicol_2thumbkeys.stl]
2024-04-27 Add missing reset hole 3x6 wireless
    [cygnus_3x6_bottom_wireless.stl]
2024-04-28 Add notch for the socket.
    [cygnus_3x6_bottom.stl]
2024-04-28 Fix clearance issue.
    [cygnus_3x5_bottom_wireless.stl, cygnus_3x6_bottom_wireless.stl]
2024-05-03 Add clearance to 3x6 wireless
    [cygnus_3x6_bottom_wireless.stl]
2024-08-24 add 4x6 variant stls
    [bottom_4x6_bottom_wired.stl, cygnus_4x6_bottom_wireless.stl, cygnus_4x6_top.stl]
2024-09-02 add separate stls for rp2040 holder
    [controller_holder_rp2040z_adapter.stl, controller_holder_rp2040z_clamp.stl]
2024-09-14 add step files for 4x6
    [4x6_bottom_wired.step, 4x6_bottom_wireless.step, 4x6_top.step]
2024-09-29 add image of wiring for right side to readme
2024-09-29 udpate image to have keyboard atop wires like left side image does
2024-10-27 Add holder for seeed studio xiao, rearrange files
    [controller holder xiao.step, controller holder xiao.stl, controller_holder_supermini_wireless.stl, cygnus_3x5_bottom.step, cygnus_3x5_bottom.stl, cygnus_3x5_bottom_wireless.step, cygnus_3x5_bottom_wireless.stl, cygnus_3x5_top.step]
2025-01-10 Add 4x6 fusion file, replaced 3x6 models with unified keywell model
    [cygnus_3x6_bottom.stl, cygnus_3x6_bottom_wired.step, cygnus_3x6_bottom_wired.stl, cygnus_3x6_bottom_wireless.step, cygnus_3x6_bottom_wireless.stl, cygnus_3x6_top.step, cygnus_3x6_top.stl, cygnus_3x6_unicol_top.stl]
2025-01-26 Add seeed xiao and rgb led wiring.
